SethNeumann/MRCS-Optical-Detector/README.md

# MRCS-DAPD-DFM
## License: Creative Commons Attribution-NonCommercial-ShareAlike

Ambiant light optical detector based on GBunza DAPD with Chubb style hysteresis

DFM, PTH parts, offboard detectors...
