SethNeumann/MRCS-Optical-Detector/MRCS-Optical-Detector.brd

## EAGLE design MRCS-Optical-Detector.brd (2019-11-28)

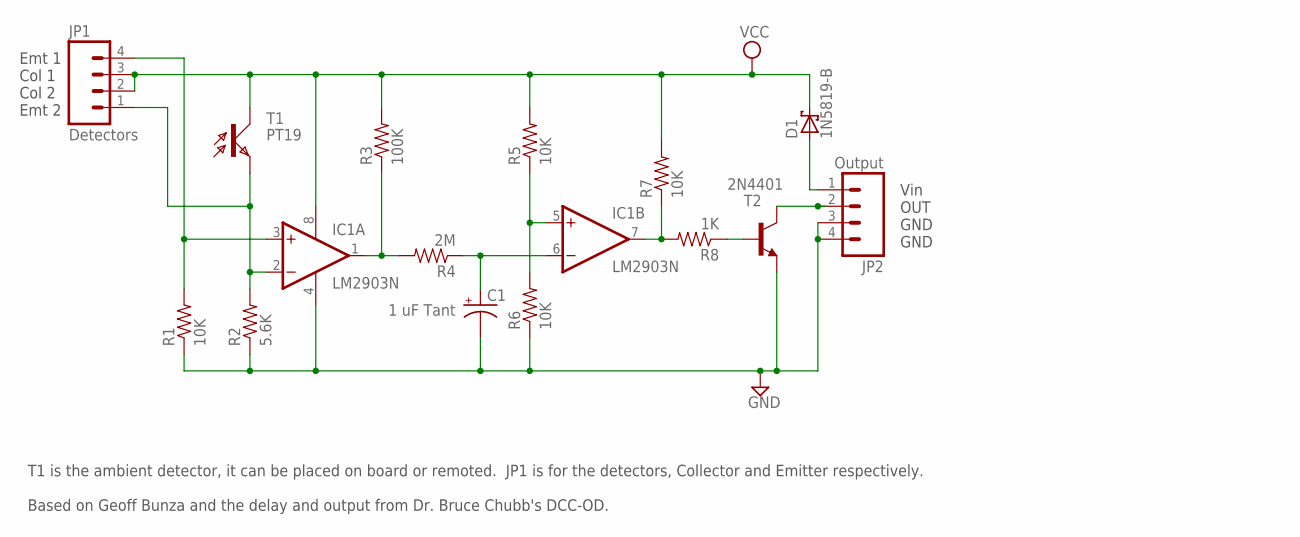
[picture p1: schematic MRCS-Optical-Detector.sch]

Parts:
C1: 1 uF Tant; E2.5-5
D1: 1N5819-B; DO41-7.6
IC1: LM2903N; DIL08
JP1: Detectors; 1X04_LOCK
JP2: Output; 1X04_LOCK
R1, R5, R6, R7: 10K; AXIAL-0.4
R2: 5.6K; AXIAL-0.4
R3: 100K; AXIAL-0.4
R4: 2M; AXIAL-0.4
R8: 1K; AXIAL-0.4
T1: PT19; BPX81
T2: 2N4401; TO92-EBC

Connections:
GND: C1.-, IC1.4 (V-), JP2.3, JP2.4, R1.P$1 (1), R2.P$1 (1), R6.P$1 (1), T2.E
unnamed: IC1.2 (-IN), JP1.1, R2.P$2 (2), T1.E
unnamed: C1.+, IC1.6 (-IN), R4.P$1 (1)
unnamed: IC1.3 (+IN), JP1.4, R1.P$2 (2)
unnamed: IC1.1 (OUT), R3.P$1 (1), R4.P$2 (2)
unnamed: IC1.7 (OUT), R7.P$1 (1), R8.P$2 (2)
unnamed: IC1.5 (+IN), R5.P$1 (1), R6.P$2 (2)
unnamed: R8.P$1 (1), T2.B
unnamed: JP2.2, T2.C
VCC: D1.C, IC1.8 (V+), JP1.2, JP1.3, R3.P$2 (2), R5.P$2 (2), R7.P$2 (2), T1.C
VIN: D1.A, JP2.1

Notes on the sheet:
Vin OUT GND GND
Emt 1 Col 1 Col 2 Emt 2
T1 is the ambient detector, it can be placed on board or remoted. JP1 is for the detectors, Collector and Emitter respectively. Based on Geoff Bunza and the delay and output from Dr. Bruce Chubb's DCC-OD.

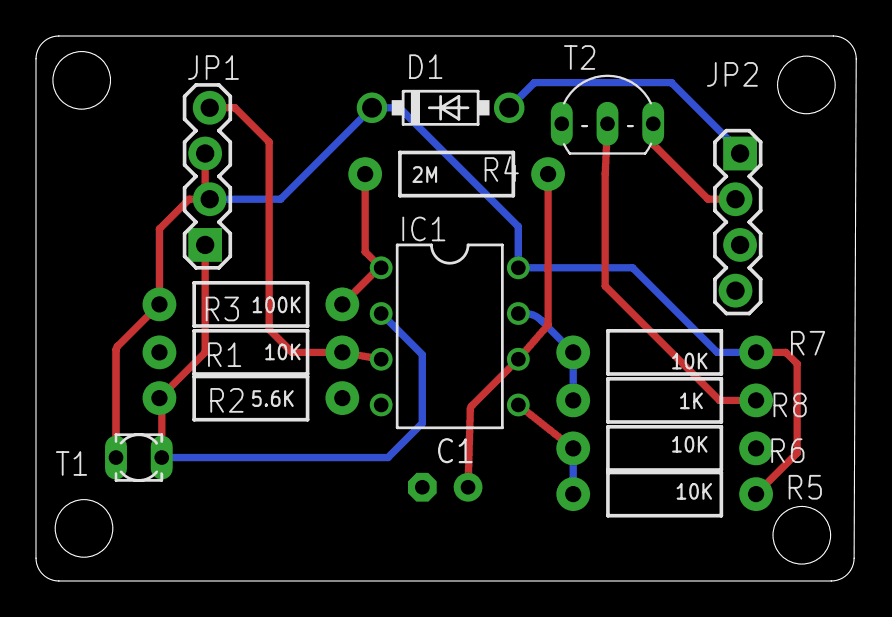
[picture p2: board MRCS-Optical-Detector.brd from above]

Board: 2 copper layers, 45.6 x 30.3 mm, 17 parts (1 on the bottom side), 11 nets.

Other parts of the board:
U$1: MRCSLOGOBTM
U$3: CA-PROP65WARNING
